ibovegar/nobs-fs-avionics/models/enclosure_top.stl

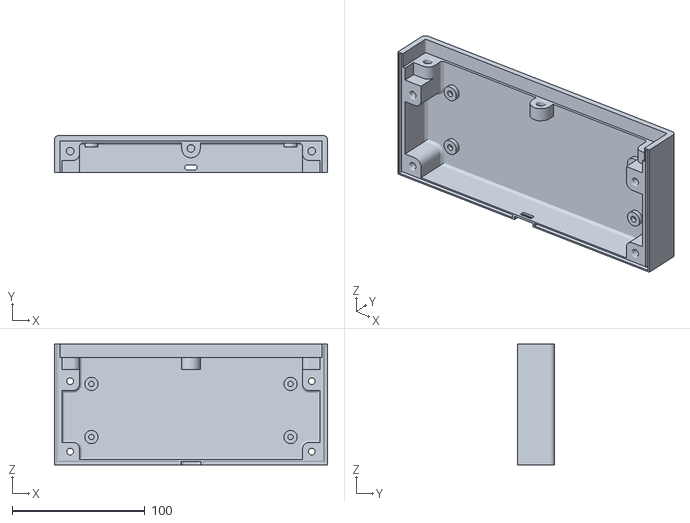
[picture p1: CAD file, 2026-11-01]
models/enclosure_top.stl
205.6 x 27.8 x 91.0
