ibovegar/nobs-fs-avionics/models/enclosure_bottom.stl

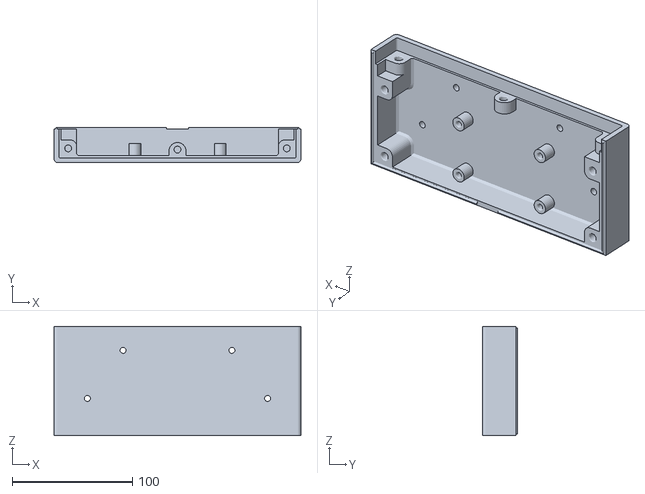
[picture p2: CAD file, 2026-11-01]
models/enclosure_bottom.stl
205.6 x 29.3 x 91.0
