ibovegar/nobs-fs-avionics/models/nobs_avionics_frontpanel.stl

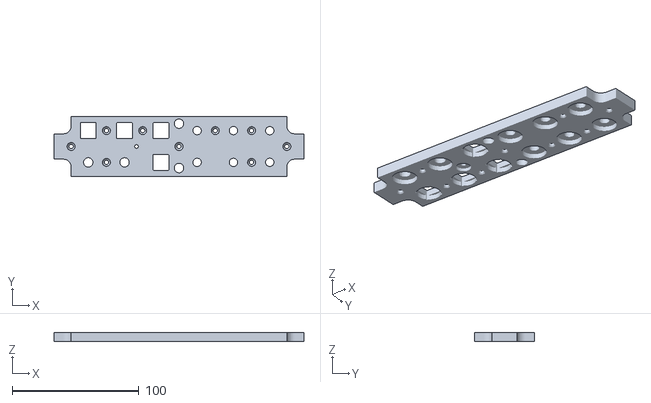
[picture p3: CAD file, 2026-11-01]
models/nobs_avionics_frontpanel.stl
197.0 x 47.0 x 7.00
