ibovegar/nobs-fs-avionics/models/nobs_avionics_mounting_plate.stl

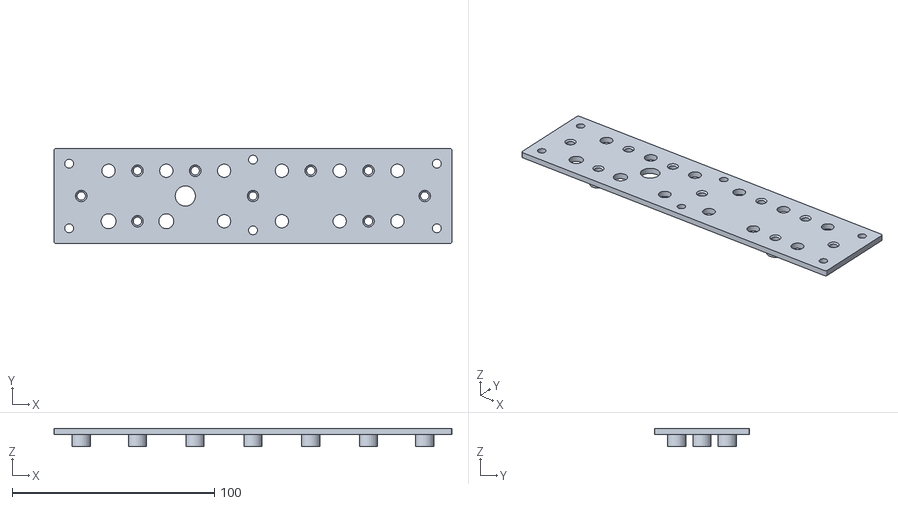
[picture p4: CAD file, 2026-11-01]
models/nobs_avionics_mounting_plate.stl
197.0 x 47.0 x 9.00
