ibovegar/nobs-fs-avionics/docs/wiring-diagram.html

nobs fs · nobs-fs-avionics · Arduino Nano ESP32

# Nobs Avionics wiring

4 push buttons · 2 encoders · 6 (ON)-OFF-(ON) momentary toggles · status LED. Pins match arduino-esp-32-wiring.md and the firmware. A printable copy of the drawing is in wiring-diagram.svg.

FRONT VIEW · USB UP · ANALOG HEADER ON THE LEFT · NOT TO SCALE

push button encoder toggle LED GND (one net)

## Pin map

Control | Lug | Pin | GPIO | HID
Left header · as drawn
PB1 | Signal | A0 | 1 | 5
PB2 | Signal | A1 | 2 | 6
PB3 | Signal | A2 | 3 | 7
ENC1 | Phase B | A3 | 4 | 2
ENC1 | Phase A | A4 | 11 | 1
ENC2 | Phase B | A5 | 12 | 4
ENC2 | Phase A | A6 | 13 | 3
PB4 | Signal | A7 | 14 | 8
Right header · as drawn
T3 | DOWN throw | D12 | 47 | 14
T3 | UP throw | D11 | 38 | 13
T6 | UP throw | D10 | 21 | 19
T6 | DOWN throw | D9 | 18 | 20
T2 | UP throw | D8 | 17 | 11
T2 | DOWN throw | D7 | 10 | 12
T5 | UP throw | D6 | 9 | 17
T5 | DOWN throw | D5 | 8 | 18
T1 | UP throw | D4 | 7 | 9
T1 | DOWN throw | D3 | 6 | 10
T4 | UP throw | D2 | 5 | 15
T4 | DOWN throw | D0·RX | 44 | 16
LED | Anode via 120 Ω | D1·TX | 43 | —
Ground
Every common, center lug and second terminal, plus the LED cathode | | | | GND

## Firmware constants

Copy

// Arduino Nano ESP32, Arduino pin names
// Every input: pinMode(pin, INPUT_PULLUP); pressed == LOW

// Left header: push buttons + encoders
constexpr uint8_t PIN_PB1    = A0;
constexpr uint8_t PIN_PB2    = A1;
constexpr uint8_t PIN_PB3    = A2;
constexpr uint8_t PIN_PB4    = A7;
constexpr uint8_t PIN_ENC1_A = A4;
constexpr uint8_t PIN_ENC1_B = A3;
constexpr uint8_t PIN_ENC2_A = A6;
constexpr uint8_t PIN_ENC2_B = A5;

// Right header: toggles (momentary UP / DOWN)
constexpr uint8_t PIN_T1_UP = D4,  PIN_T1_DN = D3;
constexpr uint8_t PIN_T2_UP = D8,  PIN_T2_DN = D7;
constexpr uint8_t PIN_T3_UP = D11, PIN_T3_DN = D12;
constexpr uint8_t PIN_T4_UP = D2,  PIN_T4_DN = D0;
constexpr uint8_t PIN_T5_UP = D6,  PIN_T5_DN = D5;
constexpr uint8_t PIN_T6_UP = D10, PIN_T6_DN = D9;

// Status LED via 120 Ω: HIGH = on
constexpr uint8_t PIN_LED = D1;

## Build notes

- As built: buttons and encoders on the analog header, toggles and LED on the digital header. Some controls were soldered to other pins than first planned; the firmware pin map matches this drawing.
- LED is on D1 (D4 is taken by T1); it blinks for up to 30 s while waiting for USB. D13 is the one spare pin. Toggle lever UP closes the lug opposite the lever: swap UP/DN in firmware if reversed.
- You solder from the back, where left and right are swapped.
- No pull-up resistors needed. Every switch closes to GND and the firmware uses INPUT_PULLUP (pressed reads LOW).
- Ground: chain every GND lug with one wire per side and land it on a GND pin. All GND tags are the same net.
- 3.3 V logic only. Never put 5 V on a GPIO pin.
