ibovegar/nobs-fs-avionics/firmware/arduino_eps32_nano/arduino_eps32_nano.ino

// Nobs Avionics — Arduino Nano ESP32 (ESP32-S3) USB HID gamepad firmware.
//
// Derived from the Nobs Autopilot firmware. Exposes 20 buttons:
//   buttons  0..3   → 2 encoders × (CW, CCW)           (no push switches)
//   buttons  4..7   → 4 push buttons (PB1..PB4)
//   buttons  8..19  → 6 momentary (ON)-OFF-(ON) toggles × (UP, DOWN) (T1..T6)
// See docs/arduino-esp-32-wiring.md for the full button + pin table and
// docs/wiring-diagram.svg for the drawing.
//
// Host config: over the USB CDC serial port the app sets encoder acceleration
// sensitivity and can reassign the board's USB identity — see the serial protocol
// near handleSerialConfig().
//
// ── Arduino IDE Tools settings (required) ─────────────────────────────────────
//   Board:        "Arduino Nano ESP32"
//   USB Mode:     "Normal mode (TinyUSB)"    ← the default; needed for custom HID
//   Pin Numbers:  "By Arduino pin (default)"  so D0/A0… match the wiring doc
// No other Tools changes and NO edits to the installed Arduino core are needed — the
// whole USB-identity fix lives in this repo (this sketch + build_opt.h beside it).
//
// ── USB identity: dynamic, stored in NVS (Preferences) ────────────────────────
// The device enumerates with VID 0x303A (Espressif's vendor ID) and a PID + product
// name that are *configurable at runtime*. Each Nobs box gets its own PID so MSFS
// can't mirror/overwrite control bindings across panels. Out of the box this build
// defaults to PID 0x8104 / "Nobs Avionics" (the block after the yoke's 8100–8103).
//
// The PID and name live in flash via the native Preferences library (NVS). On boot
// the firmware reads them *before* USB.begin() and applies them to the descriptor.
// The configuration app can change them over the USB CDC serial port (see the serial
// protocol below); after a change the firmware reboots so USB re-enumerates.
//
// That only works because the Nano ESP32 normally forces "USB CDC On Boot" and "DFU On
// Boot" on, which would make the core bring USB up at boot (before setup()), freezing
// the descriptor with the stock 0x2341/0x0070 identity. The build_opt.h file next to
// this sketch overrides both to 0 (it is appended to every compile, including the
// core's), so the boot-time USB.begin() is skipped and our runtime identity wins.
//
// Because "CDC On Boot" is then off, the core's `Serial` is the hardware UART — so the
// app's config port is our own USB CDC interface (the USBSerial object below). The
// UART is never started, which leaves D0 (RX) free as a toggle input and D1 (TX) free
// to drive the status LED.
//
// Re-flashing: the running firmware reports a custom PID (and, with DFU-on-boot off, no
// DFU runtime interface), so the IDE can't auto-enter the bootloader. Double-tap the
// RESET button (RGB LED pulses) before uploading. See this folder's README.md.

#include "USB.h"
#include "USBHID.h"
#include "USBCDC.h"
#include <EEPROM.h>
#include <Preferences.h>
#include "soc/usb_serial_jtag_reg.h"

#if ARDUINO_USB_MODE
#error "Set Tools > USB Mode to 'Normal mode (TinyUSB)'. Custom HID needs the TinyUSB stack."
#endif
#if ARDUINO_USB_CDC_ON_BOOT
#error "build_opt.h is not taking effect: ARDUINO_USB_CDC_ON_BOOT must be 0. Make sure build_opt.h sits next to this .ino (it disables CDC/DFU-on-boot so the runtime USB identity works)."
#endif

// ── Custom HID gamepad: 20 buttons, no axes ───────────────────────────────────
// 20 1-bit buttons + 4 bits of padding = a flat 3-byte report.
const uint8_t BUTTON_COUNT = 20;

static const uint8_t HID_REPORT_DESCRIPTOR[] = {
  0x05, 0x01,        // Usage Page (Generic Desktop)
  0x09, 0x05,        // Usage (Game Pad)
  0xA1, 0x01,        // Collection (Application)
  0x05, 0x09,        //   Usage Page (Button)
  0x19, 0x01,        //   Usage Minimum (Button 1)
  0x29, 0x14,        //   Usage Maximum (Button 20)
  0x15, 0x00,        //   Logical Minimum (0)
  0x25, 0x01,        //   Logical Maximum (1)
  0x75, 0x01,        //   Report Size (1)
  0x95, 0x14,        //   Report Count (20)
  0x81, 0x02,        //   Input (Data,Var,Abs)
  0x75, 0x01,        //   Report Size (1)
  0x95, 0x04,        //   Report Count (4)   — padding to a whole byte
  0x81, 0x03,        //   Input (Const,Var,Abs)
  0xC0               // End Collection
};

class NobsGamepad : public USBHIDDevice {
public:
  NobsGamepad() { HID.addDevice(this, sizeof(HID_REPORT_DESCRIPTOR)); }

  void begin() { HID.begin(); }

  // Set/clear one button bit in the pending report.
  void setButton(uint8_t index, uint8_t value) {
    if (index >= BUTTON_COUNT) return;
    uint8_t byteIdx = index >> 3;
    uint8_t mask    = 1 << (index & 7);
    if (value) report[byteIdx] |= mask;
    else       report[byteIdx] &= ~mask;
  }

  // One USB report carrying every button change since the last call. Only
  // transmitted when something actually changed — HID hosts track button state
  // edge-to-edge, so re-sending identical reports just adds USB traffic and risks
  // blocking the loop.
  void sendState() {
    if (memcmp(report, lastSent, sizeof(report)) == 0) return;
    if (HID.SendReport(0, report, sizeof(report))) {
      memcpy(lastSent, report, sizeof(report));
    }
  }

  // USBHIDDevice: hand the descriptor to the core during enumeration.
  uint16_t _onGetDescriptor(uint8_t* buffer) override {
    memcpy(buffer, HID_REPORT_DESCRIPTOR, sizeof(HID_REPORT_DESCRIPTOR));
    return sizeof(HID_REPORT_DESCRIPTOR);
  }

private:
  USBHID  HID;
  uint8_t report[3]   = { 0, 0, 0 };
  uint8_t lastSent[3] = { 0xFF, 0xFF, 0xFF }; // force the first real report out
};

NobsGamepad Joystick;

// USB CDC config port. With CDC-on-boot disabled (via build_opt.h) the core's `Serial`
// is the hardware UART, so we expose our own USB CDC interface for the app's Settings
// page. Like USBHID, USBCDC registers its interface in its constructor (static init),
// so it is in place before USB.begin() builds the composite descriptor in setup().
USBCDC USBSerial;

// ── Dynamic USB identity (NVS via Preferences) ────────────────────────────────
// VID is fixed (Espressif's vendor ID); PID + product name are stored in flash and
// host-configurable. Defaults are the avionics profile; an unconfigured chip uses
// them. (Acceleration uses the emulated-EEPROM store below; identity uses its own
// Preferences namespace, so the two don't collide.)
// NB: named NOBS_USB_VID, not USB_VID — the core's pins_arduino.h #defines USB_VID.
const uint16_t NOBS_USB_VID  = 0x303A;
const uint16_t DEFAULT_PID   = 0x8104;
const char*    DEFAULT_NAME  = "Nobs Avionics";
const char*    NVS_NAMESPACE = "nobs";
const char*    NVS_KEY_PID   = "pid";
const char*    NVS_KEY_NAME  = "name";

Preferences prefs;
uint16_t     usbPid;  // active PID (kept alive for the whole session)
String       usbName; // active product name (c_str() must outlive USB.begin())

void loadIdentity() {
  prefs.begin(NVS_NAMESPACE, true); // read-only
  usbPid  = prefs.getUShort(NVS_KEY_PID, DEFAULT_PID);
  usbName = prefs.getString(NVS_KEY_NAME, DEFAULT_NAME);
  prefs.end();
}

void storeIdentity(uint16_t pid, const String& name) {
  prefs.begin(NVS_NAMESPACE, false); // read-write
  prefs.putUShort(NVS_KEY_PID, pid);
  prefs.putString(NVS_KEY_NAME, name);
  prefs.end();
}

// ── USB string descriptors: name the interfaces after the product ─────────────
// The core hardcodes the HID/CDC *interface* strings to "TinyUSB HID"/"TinyUSB CDC".
// For a composite device (HID + CDC) Windows and MSFS show that interface string as
// the controller's name — so without this it shows up as "TinyUSB HID" even though
// iProduct is "Nobs Avionics". tud_descriptor_string_cb is weak in the core, so
// defining it here replaces it (no core edit needed) and points every interface
// string at the product name. Index map: 0=language, 1=manufacturer, 2=product,
// 3=serial (from the chip MAC, stable per board), 4+=interface strings → product.
extern "C" const uint16_t* tud_descriptor_string_cb(uint8_t index, uint16_t langid) {
  (void)langid;
  static uint16_t desc[40];

  if (index == 0) {
    desc[1] = 0x0409; // English (United States)
    desc[0] = (uint16_t)((3 << 8) | (2 * 1 + 2));
    return desc;
  }
  // Beyond our real strings (1..3 + a handful of interface strings). Returning NULL
  // mirrors the core and lets Windows' MS-OS probe at index 0xEE fail cleanly.
  if (index >= 16) return NULL;

  char serial[16];
  const char* str;
  switch (index) {
    case 1: str = "Arduino"; break;       // manufacturer (matches USB.manufacturerName)
    case 2: str = usbName.c_str(); break; // product (iProduct)
    case 3:                               // serial — stable per board
      snprintf(serial, sizeof(serial), "%012llX", (unsigned long long)ESP.getEfuseMac());
      str = serial;
      break;
    default: str = usbName.c_str(); break; // HID/CDC/config interface strings
  }

  uint8_t chr_count = strlen(str);
  if (chr_count > 38) chr_count = 38; // desc holds 39 UTF-16 chars + the header word
  for (uint8_t i = 0; i < chr_count; i++) desc[1 + i] = str[i];
  desc[0] = (uint16_t)((3 << 8) | (2 * chr_count + 2));
  return desc;
}

// ── Pin assignments (Arduino Nano ESP32 labels — see arduino-esp-32-wiring.md) ─
// Left (analog) header: push buttons + encoders. Right (digital) header: toggles +
// status LED. This is the as-built wiring: several controls ended up on other pins
// than first planned (see docs/wiring-diagram.svg).
//
// Encoders: A/B quadrature pins; common (C) to GND. No push switches.
const uint8_t ENC_COUNT = 2;
const uint8_t encA[ENC_COUNT] = { A4, A6 };
const uint8_t encB[ENC_COUNT] = { A3, A5 };

// Push buttons PB1..PB4 (one terminal to the MCU, the other to GND).
const uint8_t PB_COUNT = 4;
const uint8_t pbPin[PB_COUNT] = { A0, A1, A2, A7 };

// Momentary (ON)-OFF-(ON) toggles T1..T6: the two outer lugs go to the MCU, the
// centre lug to GND. Centred = neither pin LOW. A bat-handle toggle closes the lug
// opposite the lever; if a throw reads backwards, swap that toggle's UP/DN pins here.
// D0 is the UART RX pin, free because the hardware UART is never started.
const uint8_t TOG_COUNT = 6;
const uint8_t togUp[TOG_COUNT] = { D4, D8, D11, D2, D6, D10 };
const uint8_t togDn[TOG_COUNT] = { D3, D7, D12, D0, D5, D9 };

// NOTE: every input above is driven with INPUT_PULLUP, so the closed-to-GND wiring
// reads LOW = pressed. All of these GPIOs support the ESP32-S3 internal pull-up.
// D13 (GPIO48, the built-in amber LED) is the one spare header pin.

// ── Status LED (D1) ────────────────────────────────────────────────────────────
// LED + 120 Ω from D1 to GND. Unlike the other Nobs modules it isn't on D4, which
// T1 uses. D1 is the UART TX pin (GPIO43): the ROM bootloader prints on it at reset,
// so the LED flickers briefly at power-up before the firmware takes over the pin.
const uint8_t STATUS_LED_PIN = D1;

// ── Button index map (must match the wiring doc) ──────────────────────────────
const uint8_t encBase = 0; // encoder i: CW = encBase + 2i, CCW = encBase + 2i + 1
const uint8_t pbBase  = 4; // PB1..PB4
const uint8_t togBase = 8; // toggle i: UP = togBase + 2i, DOWN = togBase + 2i + 1

// ── Encoder rotation state ────────────────────────────────────────────────────
// Full quadrature decode: every loop read both A and B and accumulate only valid
// Gray-code transitions, so a bounce that jumps two bits, or wiggles back and
// forth, nets to zero. One detent = one full cycle = 4 counts, so we emit a
// CW/CCW step each time the accumulator crosses ±DETENT_STEPS.
//
// Each detent becomes one or more momentary CW/CCW presses, *queued* rather than
// held, and emitted as a pulse (PULSE_ON_MS) + forced low gap (PULSE_GAP_MS) so
// each one is counted as a distinct press.
//
// Pulse length is sized for MSFS, which samples gamepad state about once per frame
// (~16–33 ms): a shorter pulse can fall between two samples and never register.
// ON + GAP ≈ 30 ms caps the emit rate at ~33 presses/s. If the sim runs below 60
// fps and steps go missing, bump ON/GAP toward 20 ms.
const int8_t        DETENT_STEPS   = 4;  // quadrature counts per detent
const unsigned long PULSE_ON_MS    = 15; // CW/CCW button held high per press (~1 MSFS frame @ 60 fps)
const unsigned long PULSE_GAP_MS   = 15; // forced low gap between presses (~1 MSFS frame @ 60 fps)
const int8_t        STEP_QUEUE_MAX = 8;  // clamp pending steps (bounds post-spin tail to ~0.25 s)

// Rotational acceleration: presses emitted per detent grow with spin speed (the
// time since the previous detent on that encoder). A slow turn stays 1:1; a fast
// flick multiplies.
const unsigned long ACCEL_T1 = 80; // ms between detents; slower than this → ×1
const unsigned long ACCEL_T2 = 40; // ms
const unsigned long ACCEL_T3 = 20; // ms; faster than this → fastest multiplier
const int8_t        ACCEL_M1 = 2;  // ACCEL_T2..ACCEL_T1 ms apart
const int8_t        ACCEL_M2 = 5;  // ACCEL_T3..ACCEL_T2 ms apart
const int8_t        ACCEL_M3 = 10; // faster than ACCEL_T3 (fast flick)

// Acceleration sensitivity (0..255), *per encoder*, host-configurable and saved in
// emulated EEPROM (flash). It scales the *extra* presses from the curve above: 0 =
// acceleration off (always 1:1), 255 = the full ACCEL_M* multipliers. Each encoder
// i uses EEPROM byte EEPROM_ADDR_ACCEL + i; an uninitialised byte reads 0xFF (=255),
// so the out-of-box default is full acceleration on every knob.
const int     EEPROM_SIZE       = 8;
const int     EEPROM_ADDR_ACCEL = 0;
uint8_t       accelSens[ENC_COUNT] = { 255, 255 };

// ESP32's EEPROM is emulated in flash: writes are buffered until commit(). Only
// touch flash when the value actually changes.
void eepromUpdate(int addr, uint8_t value) {
  if (EEPROM.read(addr) != value) {
    EEPROM.write(addr, value);
    EEPROM.commit();
  }
}

// Direction of each (prevAB << 2 | currAB) transition: +1 CW, -1 CCW, 0 none/invalid.
// Same orientation as the autopilot: A-falling-with-B-high (11→01) is CW. If a knob
// turns the wrong way, swap its A and B pins in encA/encB.
const int8_t qdec[16] = {
   0, -1,  1,  0,
   1,  0,  0, -1,
  -1,  0,  0,  1,
   0,  1, -1,  0,
};

uint8_t       prevAB[ENC_COUNT];     // last (A<<1 | B) phase per encoder
int8_t        accum[ENC_COUNT];      // accumulated quadrature counts toward a detent
int8_t        pending[ENC_COUNT];    // queued steps not yet pulsed (signed: + CW, − CCW)
unsigned long lastStepMs[ENC_COUNT]; // millis() of the previous detent (for acceleration)
bool          pulseOn[ENC_COUNT];    // is a CW/CCW press currently asserted?
int           pulseBtn[ENC_COUNT];   // which button that press is on
unsigned long phaseUntil[ENC_COUNT]; // millis() when the current on/gap phase ends

// ── Host serial config ───────────────────────────────────────────────────────
// Line protocol over the USB CDC port (the app's Settings page).
//
// Acceleration — each encoder has its own sensitivity, addressed by a single-digit
// index i (0..1):
//   "A<i><n>\n"  set encoder i sensitivity to n (0..255), persisted to EEPROM
//   "A<i>?\n"    query encoder i sensitivity
// Either way we reply "A<i>=<n>\n" so the host can confirm/read the stored value.
//
// Identity — reassign the board's USB PID + product name (persisted to NVS):
//   "SET_ID:<pidHex>:<name>\n"  store PID (hex, e.g. 8104) + name, then soft-reboot
//                               so the new identity takes effect; replies "OK:<pid>:<name>"
//   "GET_ID\n"                  reply "ID:<pidHex>:<name>" with the stored values
char    cmdBuf[64];
uint8_t cmdLen = 0;

void applyAccelCommand(const char* s) {
  if (s[0] != 'A') return;
  uint8_t i = s[1] - '0';
  if (i >= ENC_COUNT) return;  // need a valid encoder index
  const char* rest = s + 2;    // value or '?' follows the index
  if (rest[0] != '?' && rest[0] != '\0') {
    long v = atol(rest);
    if (v < 0) v = 0;
    else if (v > 255) v = 255;
    accelSens[i] = (uint8_t)v;
    eepromUpdate(EEPROM_ADDR_ACCEL + i, accelSens[i]); // only writes if changed
  }
  USBSerial.print('A');
  USBSerial.print(i);
  USBSerial.print('=');
  USBSerial.println(accelSens[i]);
}

void printIdentity(const char* prefix) {
  char pidHex[5];
  snprintf(pidHex, sizeof(pidHex), "%04X", usbPid);
  USBSerial.print(prefix);
  USBSerial.print(':');
  USBSerial.print(pidHex);
  USBSerial.print(':');
  USBSerial.println(usbName);
}

void applyIdCommand(const char* s) {
  if (strcmp(s, "GET_ID") == 0) {
    printIdentity("ID");
    return;
  }
  if (strncmp(s, "SET_ID:", 7) != 0) return;

  const char* p     = s + 7;          // "<pidHex>:<name>"
  const char* colon = strchr(p, ':');
  if (!colon || colon == p) return;   // need a PID and a separator

  char pidStr[8] = { 0 };
  size_t n = colon - p;
  if (n >= sizeof(pidStr)) return;
  memcpy(pidStr, p, n);
  uint16_t pid = (uint16_t)strtol(pidStr, nullptr, 16);

  String name = colon + 1;            // everything after the second ':'
  name.trim();
  if (name.length() == 0) return;

  storeIdentity(pid, name);
  usbPid  = pid;                       // reflect the just-stored values
  usbName = name;
  printIdentity("OK");
  USBSerial.flush();
  delay(50);                           // let the CDC packet drain before reset
  ESP.restart();
}

void applyConfigCommand(const char* s) {
  if (strncmp(s, "SET_ID:", 7) == 0 || strcmp(s, "GET_ID") == 0) applyIdCommand(s);
  else applyAccelCommand(s);
}

void handleSerialConfig() {
  while (USBSerial.available()) {
    char c = USBSerial.read();
    if (c == '\n' || c == '\r') {
      cmdBuf[cmdLen] = '\0';
      if (cmdLen > 0) applyConfigCommand(cmdBuf);
      cmdLen = 0;
    } else if (cmdLen < sizeof(cmdBuf) - 1) {
      cmdBuf[cmdLen++] = c;
    } else {
      cmdLen = 0; // overlong line (no newline) — drop it and resync
    }
  }
}

// ── USB enumeration tracking (for the status LED) ─────────────────────────────
// ARDUINO_USB_STARTED_EVENT fires once the host finishes recognizing the composite
// device, ARDUINO_USB_STOPPED_EVENT if it's unplugged or the bus drops. So
// "connected" here means "enumerated by a host", not "the app has it open" — there's
// no such signal for a plain HID gamepad.
volatile bool hostConnected = false;

void onUsbEvent(void* arg, esp_event_base_t base, int32_t id, void* eventData) {
  (void)arg;
  (void)base;
  (void)eventData;
  if (id == ARDUINO_USB_STARTED_EVENT) hostConnected = true;
  else if (id == ARDUINO_USB_STOPPED_EVENT) hostConnected = false;
}

// Blink while booting/waiting for USB enumeration; steady once enumerated. If a host
// never shows up (data-less cable, charger, no PC attached), give up blinking after
// STATUS_LED_TIMEOUT_MS and go dark rather than blink forever — the wait window
// restarts if the host later disconnects. Non-blocking so it never stalls loop().
const uint32_t STATUS_LED_TIMEOUT_MS = 30000;

void updateStatusLed() {
  static bool     wasConnected = false;
  static uint32_t waitStart    = 0;
  static uint32_t lastToggle   = 0;
  static bool     ledOn        = false;
  uint32_t now = millis();

  if (hostConnected) {
    digitalWrite(STATUS_LED_PIN, HIGH);
    wasConnected = true;
    return;
  }

  if (wasConnected) {
    // Just dropped from connected to disconnected — restart the blink window.
    wasConnected = false;
    waitStart = now;
  }

  if (now - waitStart >= STATUS_LED_TIMEOUT_MS) {
    digitalWrite(STATUS_LED_PIN, LOW); // gave up waiting; stay dark until enumerated
    return;
  }

  if (now - lastToggle >= 150) {
    lastToggle = now;
    ledOn = !ledOn;
    digitalWrite(STATUS_LED_PIN, ledOn);
  }
}

// ── Clean USB hand-over on a cold plug-in ─────────────────────────────────────
// At power-up the ESP32-S3 first appears on the bus as its built-in "USB JTAG/serial
// debug unit" (303A:1001). If the host never sees that device drop off the bus it
// keeps the stale entry and never enumerates ours. Dropping the D+ pull-up for a
// moment makes the host register a real disconnect first.
const uint32_t USB_DETACH_MS = 250;

void detachBuiltinUsb() {
  SET_PERI_REG_MASK(USB_SERIAL_JTAG_CONF0_REG, USB_SERIAL_JTAG_PAD_PULL_OVERRIDE);
  CLEAR_PERI_REG_MASK(USB_SERIAL_JTAG_CONF0_REG, USB_SERIAL_JTAG_DP_PULLUP);
  delay(USB_DETACH_MS);
}

// Hand pull-up control back (register defaults) once TinyUSB owns the pins.
void releaseBuiltinUsbPulls() {
  SET_PERI_REG_MASK(USB_SERIAL_JTAG_CONF0_REG, USB_SERIAL_JTAG_DP_PULLUP);
  CLEAR_PERI_REG_MASK(USB_SERIAL_JTAG_CONF0_REG, USB_SERIAL_JTAG_PAD_PULL_OVERRIDE);
}

void setup() {
  for (uint8_t i = 0; i < ENC_COUNT; i++) {
    pinMode(encA[i], INPUT_PULLUP);
    pinMode(encB[i], INPUT_PULLUP);
    prevAB[i] = (digitalRead(encA[i]) << 1) | digitalRead(encB[i]);
    accum[i] = 0;
    pending[i] = 0;
    lastStepMs[i] = 0;
    pulseOn[i] = false;
    pulseBtn[i] = -1;
    phaseUntil[i] = 0;
  }
  for (uint8_t i = 0; i < PB_COUNT; i++) {
    pinMode(pbPin[i], INPUT_PULLUP);
  }
  for (uint8_t i = 0; i < TOG_COUNT; i++) {
    pinMode(togUp[i], INPUT_PULLUP);
    pinMode(togDn[i], INPUT_PULLUP);
  }
  pinMode(STATUS_LED_PIN, OUTPUT);
  digitalWrite(STATUS_LED_PIN, LOW);

  // Load each encoder's saved acceleration sensitivity (0xFF on a fresh chip → 255 = full).
  EEPROM.begin(EEPROM_SIZE);
  for (uint8_t i = 0; i < ENC_COUNT; i++) accelSens[i] = EEPROM.read(EEPROM_ADDR_ACCEL + i);

  // Load the saved identity (PID + name) from NVS, falling back to the avionics
  // defaults on a fresh chip.
  loadIdentity();

  // USB identity — set BEFORE USB.begin() so the descriptor is built with the stored
  // VID/PID/name. This works because build_opt.h disabled CDC/DFU-on-boot, so USB has
  // NOT been started yet (see the header).
  USB.VID(NOBS_USB_VID);
  USB.PID(usbPid);
  USB.productName(usbName.c_str());
  USB.manufacturerName("Arduino");

  Joystick.begin();        // create the HID report semaphores/mutex
  USB.onEvent(onUsbEvent); // detect USB enumeration, for the status LED
  USBSerial.begin(115200); // USB CDC config port; do NOT wait on it (would stall)
  detachBuiltinUsb();      // make the host drop the boot-time 303A:1001 device first
  USB.begin();             // build + start the composite USB device (HID + CDC)
  releaseBuiltinUsbPulls();
}

void loop() {
  unsigned long now = millis();

  handleSerialConfig(); // apply any pending config command
  updateStatusLed();    // blink while waiting for USB enumeration (times out to dark), steady once enumerated

  // ── Encoders ────────────────────────────────────────────────────────────────
  for (uint8_t i = 0; i < ENC_COUNT; i++) {
    // Accumulate valid quadrature transitions; emit a step each full detent.
    uint8_t ab = (digitalRead(encA[i]) << 1) | digitalRead(encB[i]);
    if (ab != prevAB[i]) {
      accum[i] += qdec[(prevAB[i] << 2) | ab];
      prevAB[i] = ab;

      int8_t dir = 0;
      if (accum[i] >= DETENT_STEPS) {
        dir = 1;            // clockwise  → CW
        accum[i] -= DETENT_STEPS;
      } else if (accum[i] <= -DETENT_STEPS) {
        dir = -1;           // counter-cw → CCW
        accum[i] += DETENT_STEPS;
      }

      if (dir != 0) {
        // Acceleration: scale presses-per-detent by how fast we're turning, then
        // by the host-set sensitivity (0 = off/1:1, 255 = full curve).
        unsigned long delta = now - lastStepMs[i];
        lastStepMs[i] = now;
        int8_t baseMult = (delta < ACCEL_T3) ? ACCEL_M3
                        : (delta < ACCEL_T2) ? ACCEL_M2
                        : (delta < ACCEL_T1) ? ACCEL_M1
                        : 1;
        int16_t mult = 1 + ((int16_t)(baseMult - 1) * accelSens[i]) / 255;
        // Queue the (scaled) steps, clamped; the generator below paces them out.
        int16_t want = pending[i] + (int16_t)dir * mult;
        if (want > STEP_QUEUE_MAX) want = STEP_QUEUE_MAX;
        else if (want < -STEP_QUEUE_MAX) want = -STEP_QUEUE_MAX;
        pending[i] = (int8_t)want;
      }
    }

    // Pulse generator: turn queued steps into distinct press/gap cycles so even
    // rapid rotation counts every detent.
    if (pulseOn[i]) {
      if (now >= phaseUntil[i]) {           // end the press → start the low gap
        Joystick.setButton(pulseBtn[i], 0);
        pulseOn[i] = false;
        phaseUntil[i] = now + PULSE_GAP_MS;
      }
    } else if (now >= phaseUntil[i] && pending[i] != 0) {
      int8_t dir = (pending[i] > 0) ? 1 : -1; // start the next queued press
      pending[i] -= dir;
      pulseBtn[i] = encBase + 2 * i + (dir > 0 ? 0 : 1);
      Joystick.setButton(pulseBtn[i], 1);
      pulseOn[i] = true;
      phaseUntil[i] = now + PULSE_ON_MS;
    }
  }

  // ── Push buttons (held level, pressed = LOW) ────────────────────────────────
  for (uint8_t i = 0; i < PB_COUNT; i++) {
    Joystick.setButton(pbBase + i, digitalRead(pbPin[i]) == LOW ? 1 : 0);
  }

  // ── Momentary toggles: each throw is its own held button ────────────────────
  for (uint8_t i = 0; i < TOG_COUNT; i++) {
    Joystick.setButton(togBase + 2 * i,     digitalRead(togUp[i]) == LOW ? 1 : 0);
    Joystick.setButton(togBase + 2 * i + 1, digitalRead(togDn[i]) == LOW ? 1 : 0);
  }

  // One USB report per loop with all the updates above (sent only when changed).
  Joystick.sendState();
}
