ibovegar/nobs-fs-avionics/(commit log)

2026-11-01 Add Nobs Avionics wiring, diagram and firmware
    - Wiring map for the Arduino Nano ESP32 (docs/arduino-esp-32-wiring.md):
    PB1-PB4 and ENC1-ENC2 on the analog header, T1-T6 momentary
    (ON)-OFF-(ON) toggles and the status LED (D1) on the digital header.
    - Wiring diagram as SVG and HTML (docs/wiring-diagram.*).
    - Firmware (firmware/arduino_eps32_nano): 20-button HID gamepad, default
    identity PID 0x8104 / "Nobs Avionics" (block 8104-8107), encoder
    acceleration, 30 s status-LED timeout.
    - Front panel and mounting plate models (models/*.stl).
    [nobs_avionics_frontpanel.stl, nobs_avionics_mounting_plate.stl]
2026-11-01 Write the README
    Describe the panel (layout, 20-button map, status LED), link the wiring
    and firmware docs, and cover the Nobs app and device ID setup.
    [enclosure_bottom.stl, enclosure_top.stl]
2026-11-02 Make the wiring diagram SVG white
    Always draw the SVG on a plain white background, also in dark-mode
    viewers. The HTML page keeps its light/dark theme.
2026-11-02 Match the wiring diagram and firmware to the as-built module
    Several controls were soldered to other pins than first planned. Redraw
    the wiring diagram and update the wiring doc and the firmware's pin map to
    the actual wiring, so every control keeps its HID button:
    - ENC1/ENC2: A and B swapped (A4/A3, A6/A5).
    - PB1 A0, PB2 A1, PB3 A2 (PB4 unchanged on A7).
    - T1 D4/D3, T2 D8/D7, T3 D11/D12, T4 D2/D0, T5 D6/D5, T6 D10/D9 (UP/DN).
    [arduino_eps32_nano.ino]
